Salifya12/3C10Vocoder/report/report.html

# Vocoder

3C10 Group 2
Muirinn Daly, Niall Maguire, Salifya Mtambo, Connor Doyle

## Description

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

There are three main stages in a Vocoder:

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

# Components

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

## Block Diagram



## Wiring Diagram




# Build and Test

## Microphone Input

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

## DAC

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

## Speaker

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

## Display

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

float freq = 200.0f + 400.0f * (analogRead(FREQ) / 1023.0f);

The value is divided by 1023 because the Arduino has a 10-bit ADC producing a number between 0.0 and 1.0. This number is multiplied by 400 and added to 200. The frequency range is from 200Hz to 600Hz. The Arduino code for the display utilises the Adafruit_SSD1306 library (https://github.com/adafruit/Adafruit_SSD1306). 

# Digital Signal Processing

## Synthesiser

### Implementation

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

First, a struct to hold the synthesiser data is defined.

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

Here, SynthType represents the types of waves to generate. This is implemented as an enum class.

enum class SynthType {
    Square   = 1<<0,
    Sawtooth = 1<<1,
    Triangle = 1<<2,
    Sine     = 1<<3
};

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

The function to generate the synthesised wave is defined as

float synth_run(Synth *synth, float dt)

The new t values for each wave is calculated with the following loop

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

if (scale != 0)
    out /= scale;

Finally, the wave is returned from the function for use elsewhere in the program.

return out;

### Testing

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

## Band Pass Filters

### Designing

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

        self.x1 = 0
        self.x2 = 0
        self.y1 = 0
        self.y2 = 0

        self._compute_coefficients()

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

import copy

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

    def get_output(self):
        return self.filters[-1].get_output()

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

import math

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

import matplotlib.pyplot as plt

def eval_signal(filter, signal, dt, step_count):
    filter.reset()

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

def eval_sine_period(filter, freq, periods, dt):
    return eval_signal(filter, SineSignal(freq), dt, int(periods/dt/freq))

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

plt.legend(["filter_1", "filter_2", "filter_3", "filter_4"])
plt.xlabel("Frequency (Hz)")
plt.ylabel("Gain")
plt.show()

This produces the following graph.



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

class SumSignal:
    def __init__(self, signals):
        self.signals = signals

    def __call__(self, t):
        out = 0
        for signal in self.signals:
            out += signal(t)
        return out

class NoiseSignal:
    def __init__(self):
        pass
    
    def __call__(self, t):
        return random() * 2 - 1

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

filter = HighOrderFilter(BiquadFilter(f_0, f_0/(f_u-f_l), 1, 1/dt), 4)

signal = SumSignal([
    SineSignal(800), SineSignal(2400), SineSignal(3800),
    SineSignal( 50), SineSignal(1800), SineSignal(2100),
    NoiseSignal()
])

plot_signal(filter, signal, dt, int(duration/dt))

This outputs the following graph:



This filter produced the expected 800 Hz sine wave with only minimal distortion.

### Implementation

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

struct Filter {
    float a1, a2, b0, b2;
};

struct FilterState {
    float x1, x2, y1, y2;
};

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

    float omega = 2.0f * (float)M_PI * f_0 / sample_rate;
    float alpha = sinf(omega) / (2.0f * Q);

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

    state->x2 = state->x1;
    state->x1 = x;
    state->y2 = state->y1;
    state->y1 = y;

    return y;
}

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

## Envelope Detectors

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

void envelope_step(float *state, float a, float x) {
    *state = (1 - a) * *state + a * std::abs(x);
}

## Vocoder

### Implementation

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

    Filter filters[filter_count];
    FilterState input_state[filter_count * cascade_count];
    FilterState carrier_state[filter_count * cascade_count];

    float envelope_state[filter_count];
};

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

float vocoder_update(Vocoder *Vocoder, float input, float synth_input) {
    float out[Vocoder->filter_count];
    float synth_out[Vocoder->filter_count];

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

        synth_out[i] = cascade_step(
            Vocoder->filters + i,
            Vocoder->carrier_state + i * Vocoder->cascade_count,
            Vocoder->cascade_count,
            synth_input
        );
    }
    ...

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

    ...
    for (int i = 0; i < Vocoder->filter_count; ++i)
        envelope_step(
            Vocoder->envelope_state + i,
            Vocoder->env_a,
            out[i]
        );
    ...

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

### Testing

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

## Putting It Together

The three main DSP components we built are: - Synthesiser - Band pass filters - Envelope detectors - Vocoder

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

static Vocoder Vocoder;
static Synth synth;

void setup() {
    Serial.begin(9600);
    
    // Initialise pins.
    ...
    
    dac_init();
    synth_init(&synth);
    vocoder_init(&Vocoder);
}

The loop method starts by reading in the use configuration from several pins.

void loop() {
    unsigned long start_time = micros();

    int run_vocoder = digitalRead(19);

    synth.type = (SynthType)(
          (digitalRead(21) << 0)
        | (digitalRead( 3) << 1)
        | (digitalRead( 1) << 2)
        | (digitalRead(22) << 3)
    );

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

It then reads in the microphone input and runs the synthesiser with the read in options.

    ...
    float input = analogRead(mic_pin) / 4095.0f;
    float synth_input = synth_run(&synth, 1.0f/8000.0f);
    ...

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

    ...
    output = (output + 1.0f) * 0.5f;
    dac_write_float(output);
    ...

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

void loop() {
    unsigned long start_time = micros();
    ...

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

## Alternate Approach

### Using one microcontroller

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

## Analogue Signal Processing

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

### Band Pass Filters

The type of band pass filter we tested was a Bessel-Thompson filter.



#### Component Values

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

Then, we define the values that we would like to use for the filter.

f_l = 500
f_u = 1500

f0 = 0.5*(f_l+f_u)
Q = f0 / (f_u-f_l)

r1 = 1000
r2 = 10000
gain = 1

Next, we use scipy’s fsolve function to numerically solve for the remaining component values.

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

roots = fsolve(f, [1e5, 1e-7, 1e-7])

# Print out the component values and the absolute errors.
print(roots)
print(f(roots))

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



This shows that our filter functions as expected.

#### Building the filter

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

The Alternate Vocoder’s block diagram is displayed below. A possible component suggestion for said Vocoder would be a THAT2181 (https://thatcorp.com/datashts/THAT_2181-Series_Datasheet.pdf) VCA for modulation.
